canismarko/pulsemixer/pulsemixer_pcb/pulsemixer_pcb.png

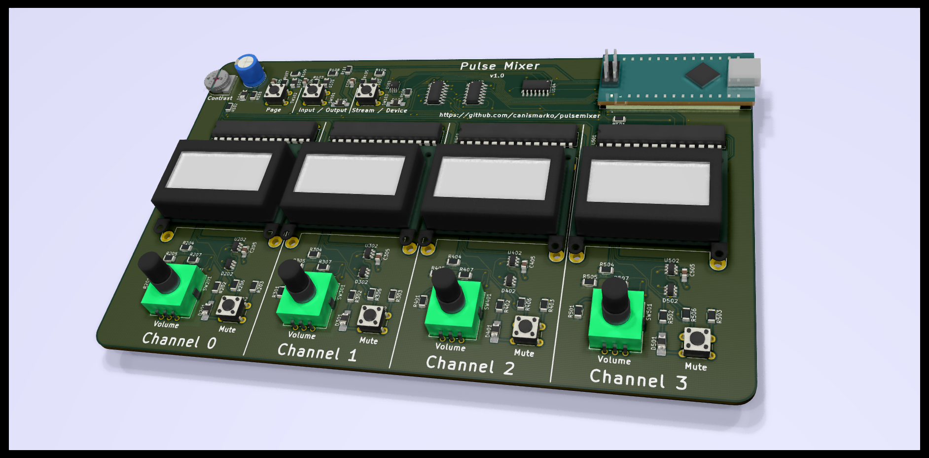
pulsemixer_pcb/pulsemixer_pcb.png
