canismarko/pulsemixer/serial_instructions.txt

* Host-To-Client
* Client-To-Host
** ``REFRESH CHANNELS``
   Ask the host to send an updated list of channel names.
