canismarko/pulsemixer/pulsemixer_pcb/NHD-0208AZ-FL-GBW.stp

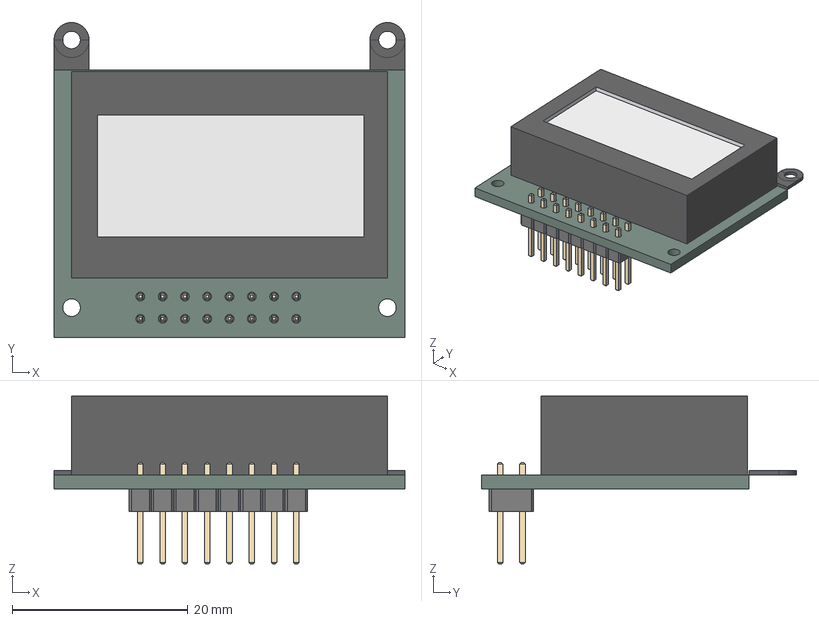
[picture p2: CAD file, 2020-07-25]
pulsemixer_pcb/NHD-0208AZ-FL-GBW.stp
40.0 x 35.9 x 19.1 mm
PinHeader
PCB001
Display001
Tab001
Tab002
