canismarko/pulsemixer/pulsemixer_pcb/EN12-HS.step

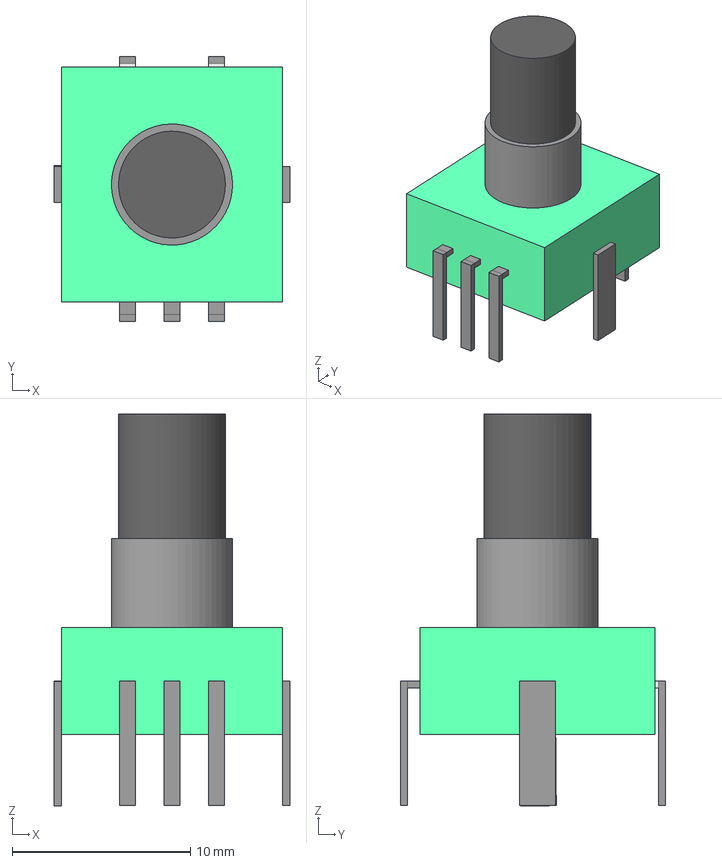
[picture p3: CAD file, 2020-07-25]
pulsemixer_pcb/EN12-HS.step
13.2 x 14.9 x 22.0 mm
BodyCube
Knob
Sheeth
BodyPins
RotaryPins
SwitchPins
