canismarko/pulsemixer/(list of files, cad)

Other CAD files:
pulsemixer_pcb/NHD-0208AZ-FL-BGW.FCStd
pulsemixer_pcb/EN12-HS.FCStd
