canismarko/pulsemixer/pulsemixer_pcb/pulsemixer_pcb.pdf

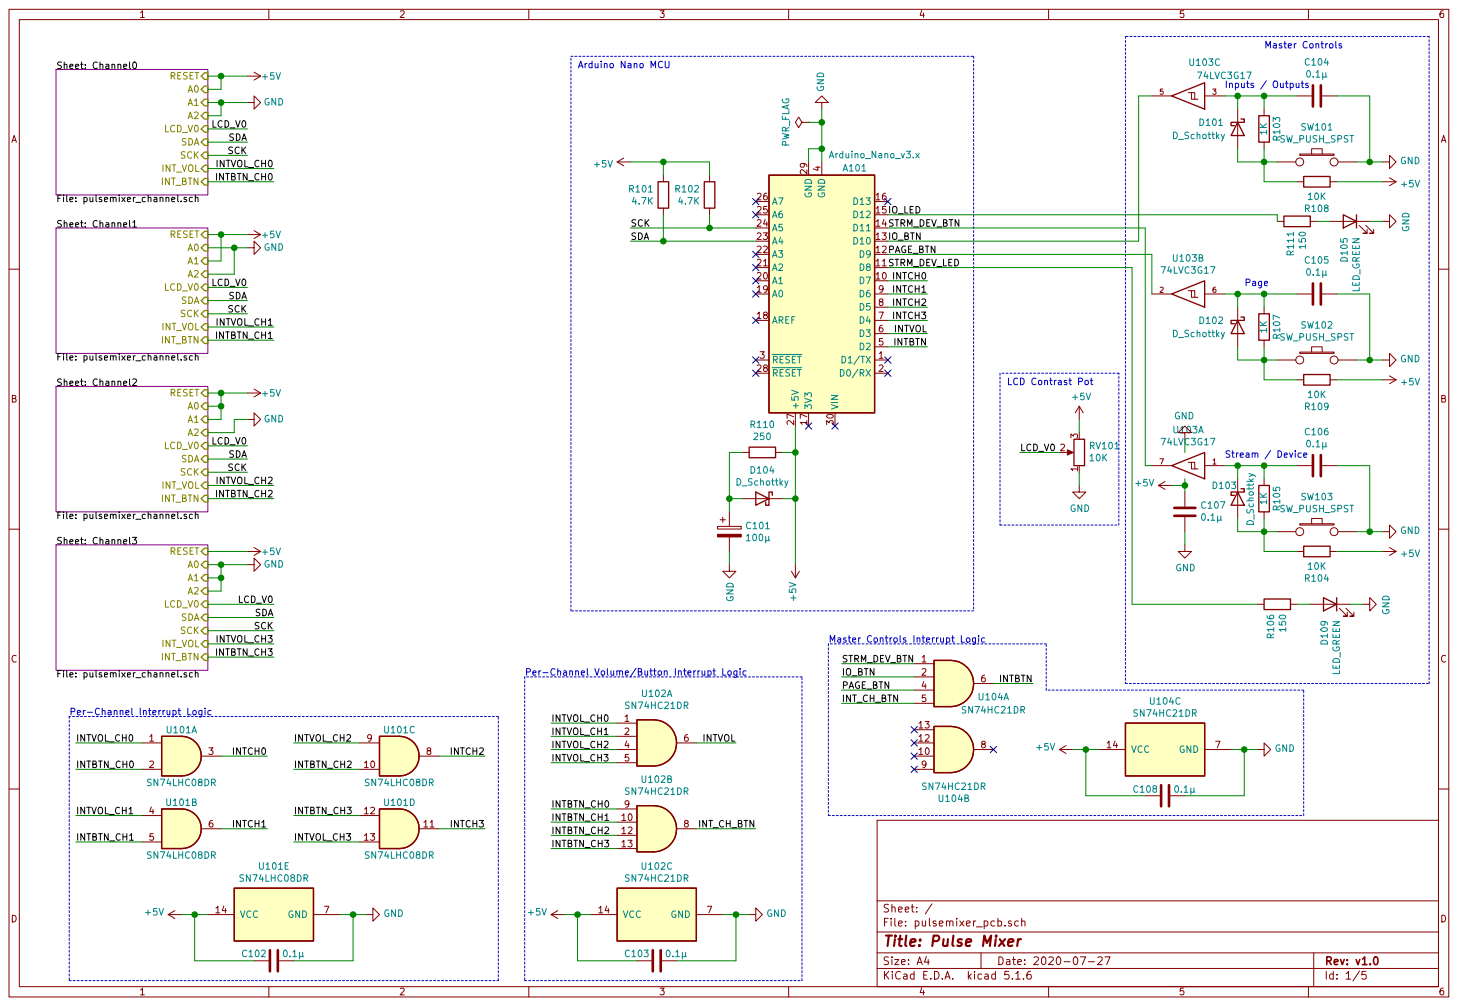
[picture p4: page 1]

LCD_V0 Sheet: Channel0 File: pulsemixer_channel.sch SCK

LCD Contrast Pot Arduino Nano MCU

LCD_V0 Sheet: Channel1 File: pulsemixer_channel.sch SCK

STRM_DEV_LED
INTCH0

LCD_V0 Sheet: Channel2 File: pulsemixer_channel.sch SCK

File: pulsemixer_pcb.sch Sheet: / Sheet: Channel3 File: pulsemixer_channel.sch SCK

Per-Channel Volume/Button Interrupt Logic

Per-Channel Interrupt Logic

Id: 1/5 Title: Pulse Mixer

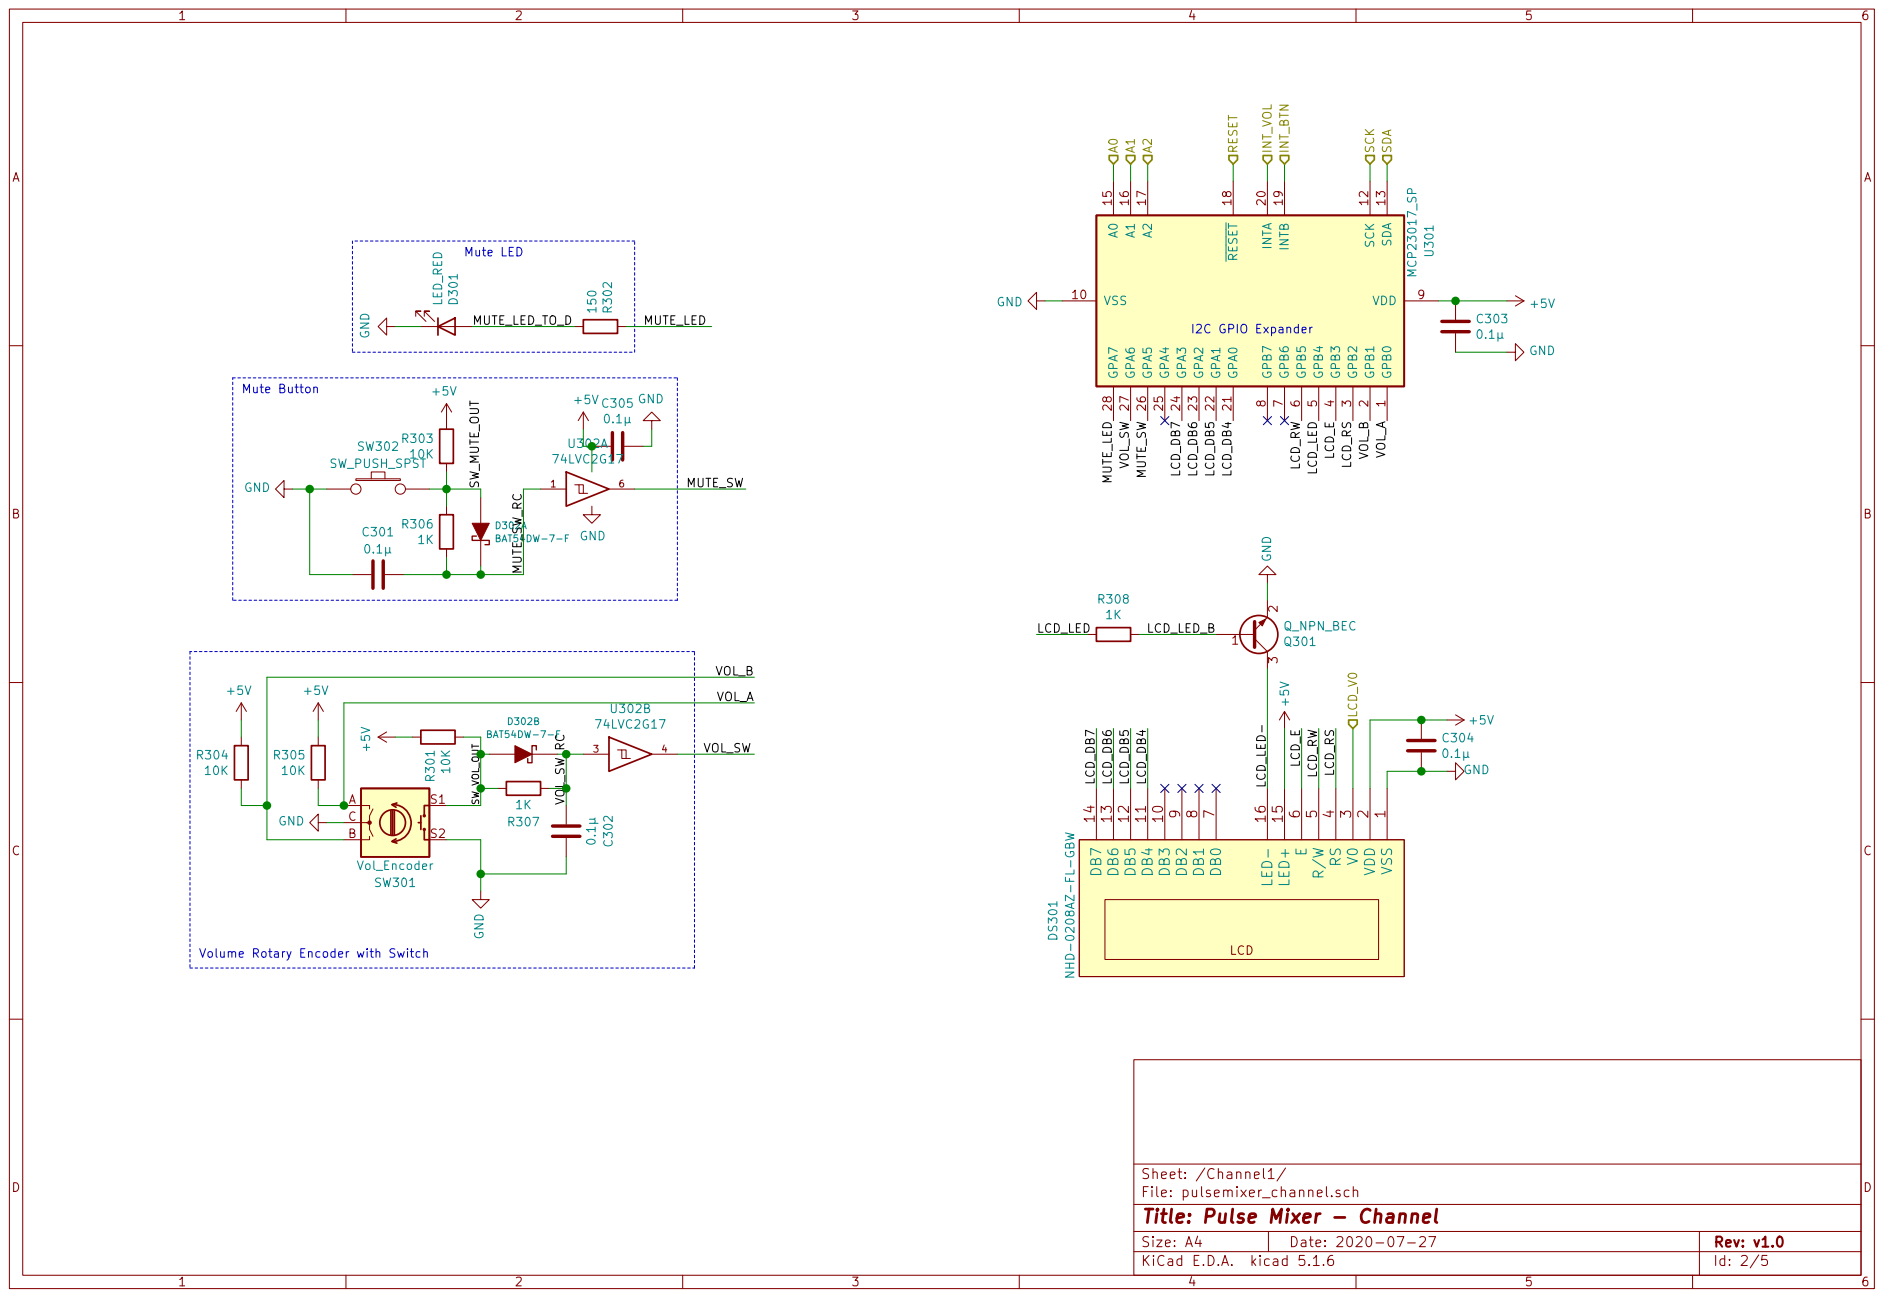
[picture p5: page 2]

I2C GPIO Expander Mute LED Mute Button Volume Rotary Encoder with Switch

File: pulsemixer_channel.sch Sheet: /Channel1/
Id: 2/5 Title: Pulse Mixer - Channel

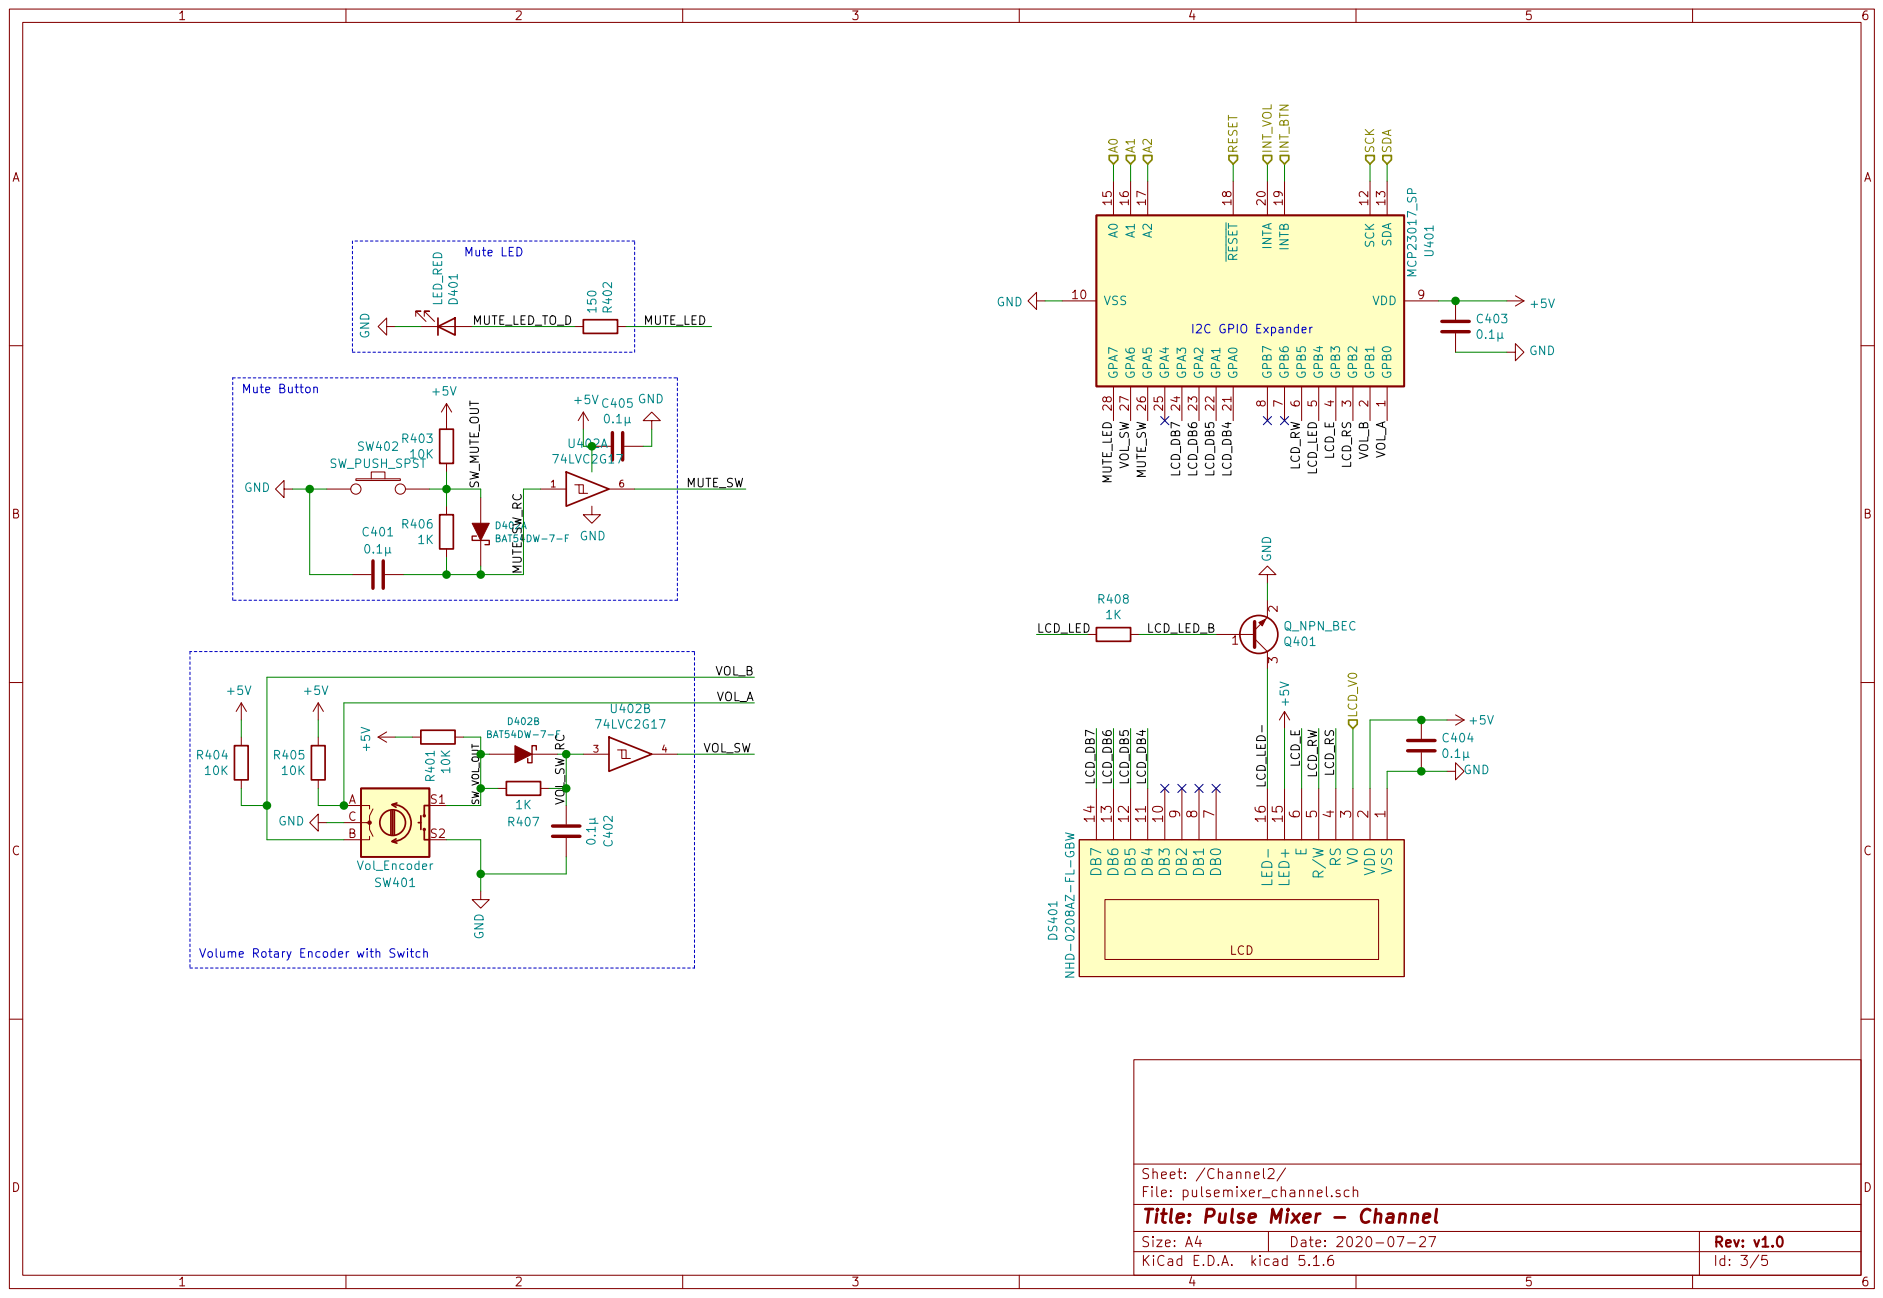
[picture p6: page 3]

I2C GPIO Expander Mute LED Mute Button Volume Rotary Encoder with Switch

File: pulsemixer_channel.sch Sheet: /Channel2/
Id: 3/5 Title: Pulse Mixer - Channel

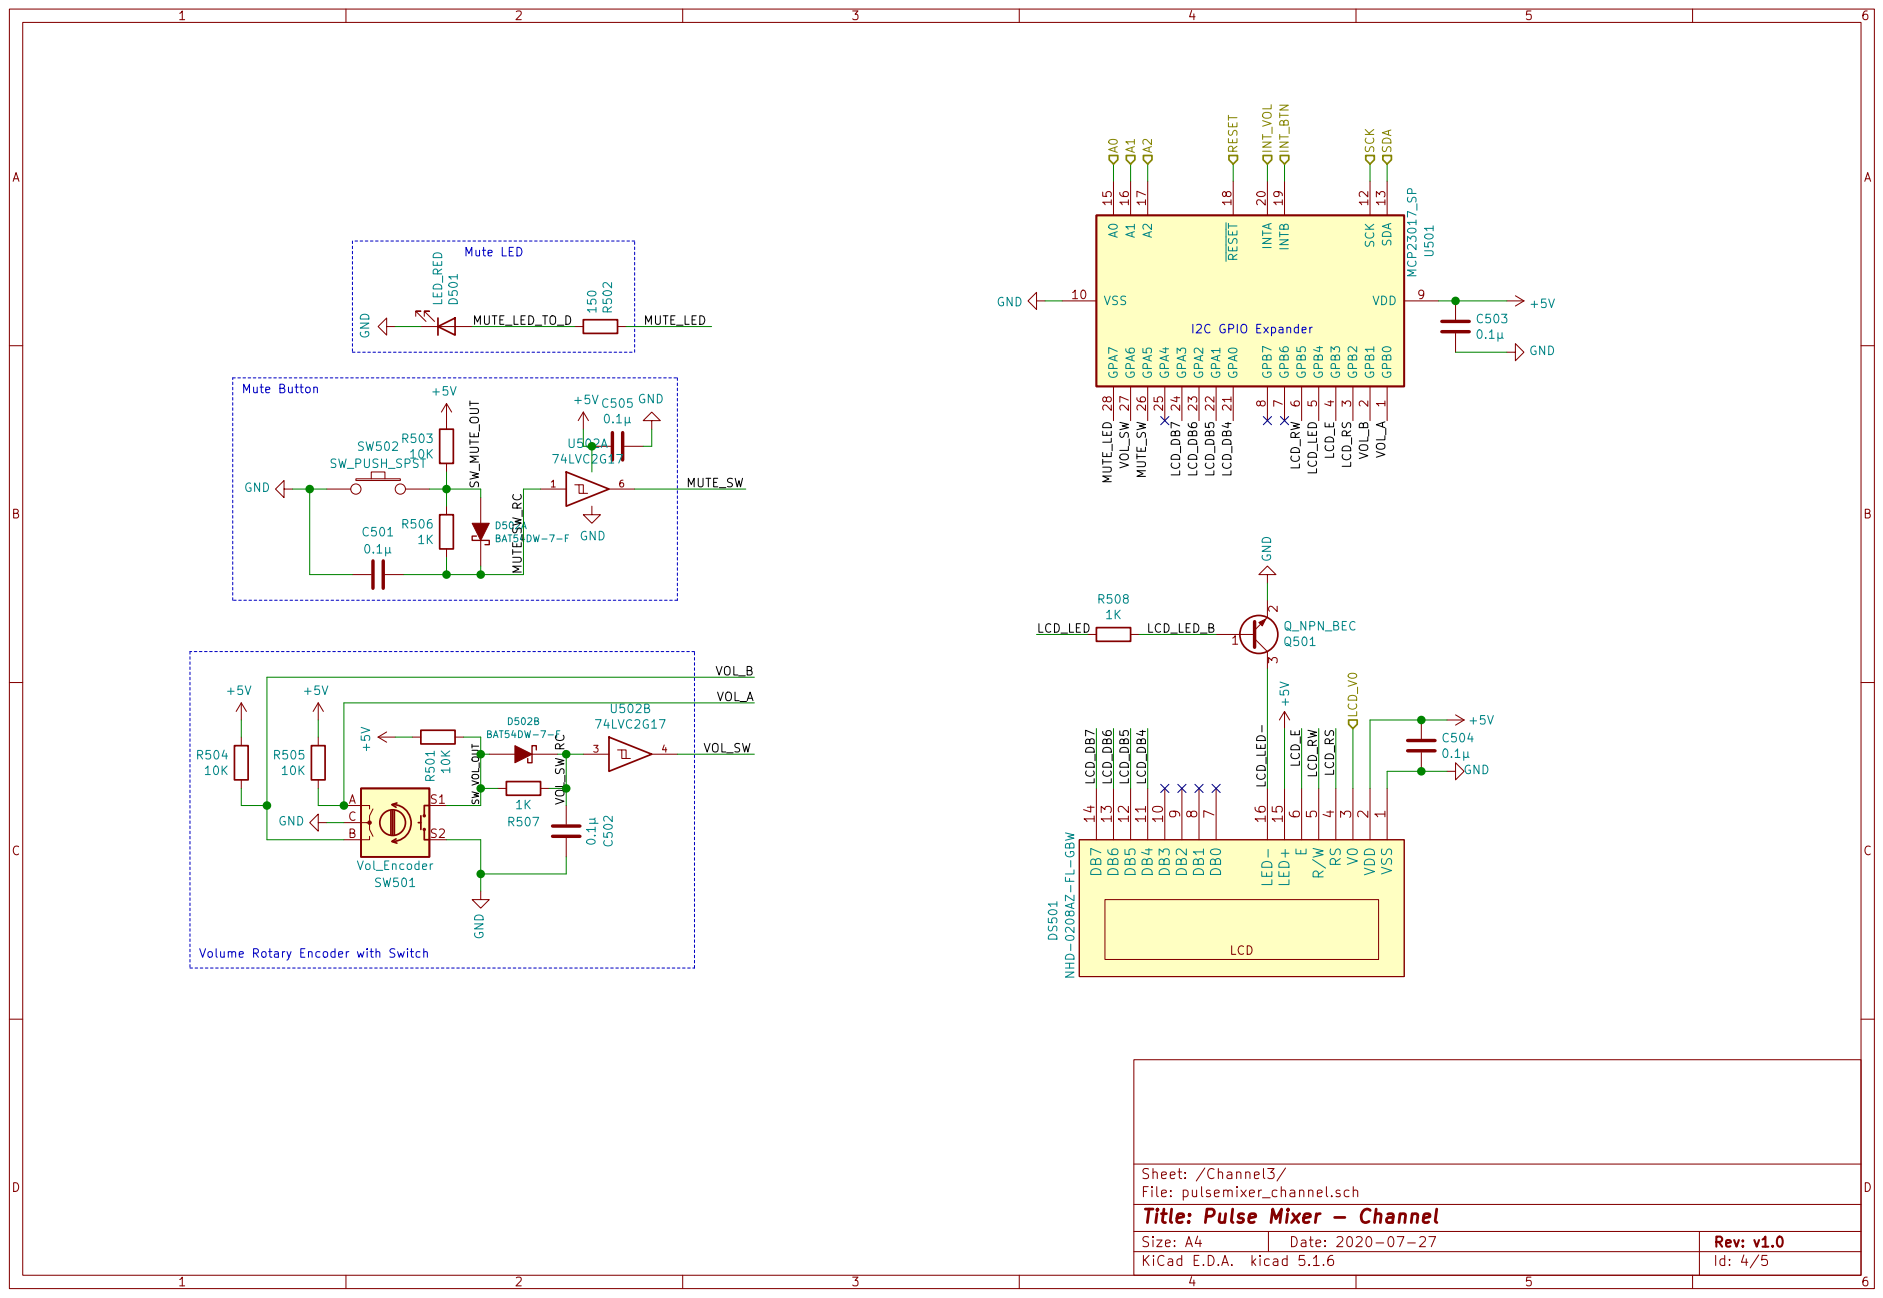
[picture p7: page 4]

I2C GPIO Expander Mute LED Mute Button Volume Rotary Encoder with Switch

File: pulsemixer_channel.sch Sheet: /Channel3/
Id: 4/5 Title: Pulse Mixer - Channel

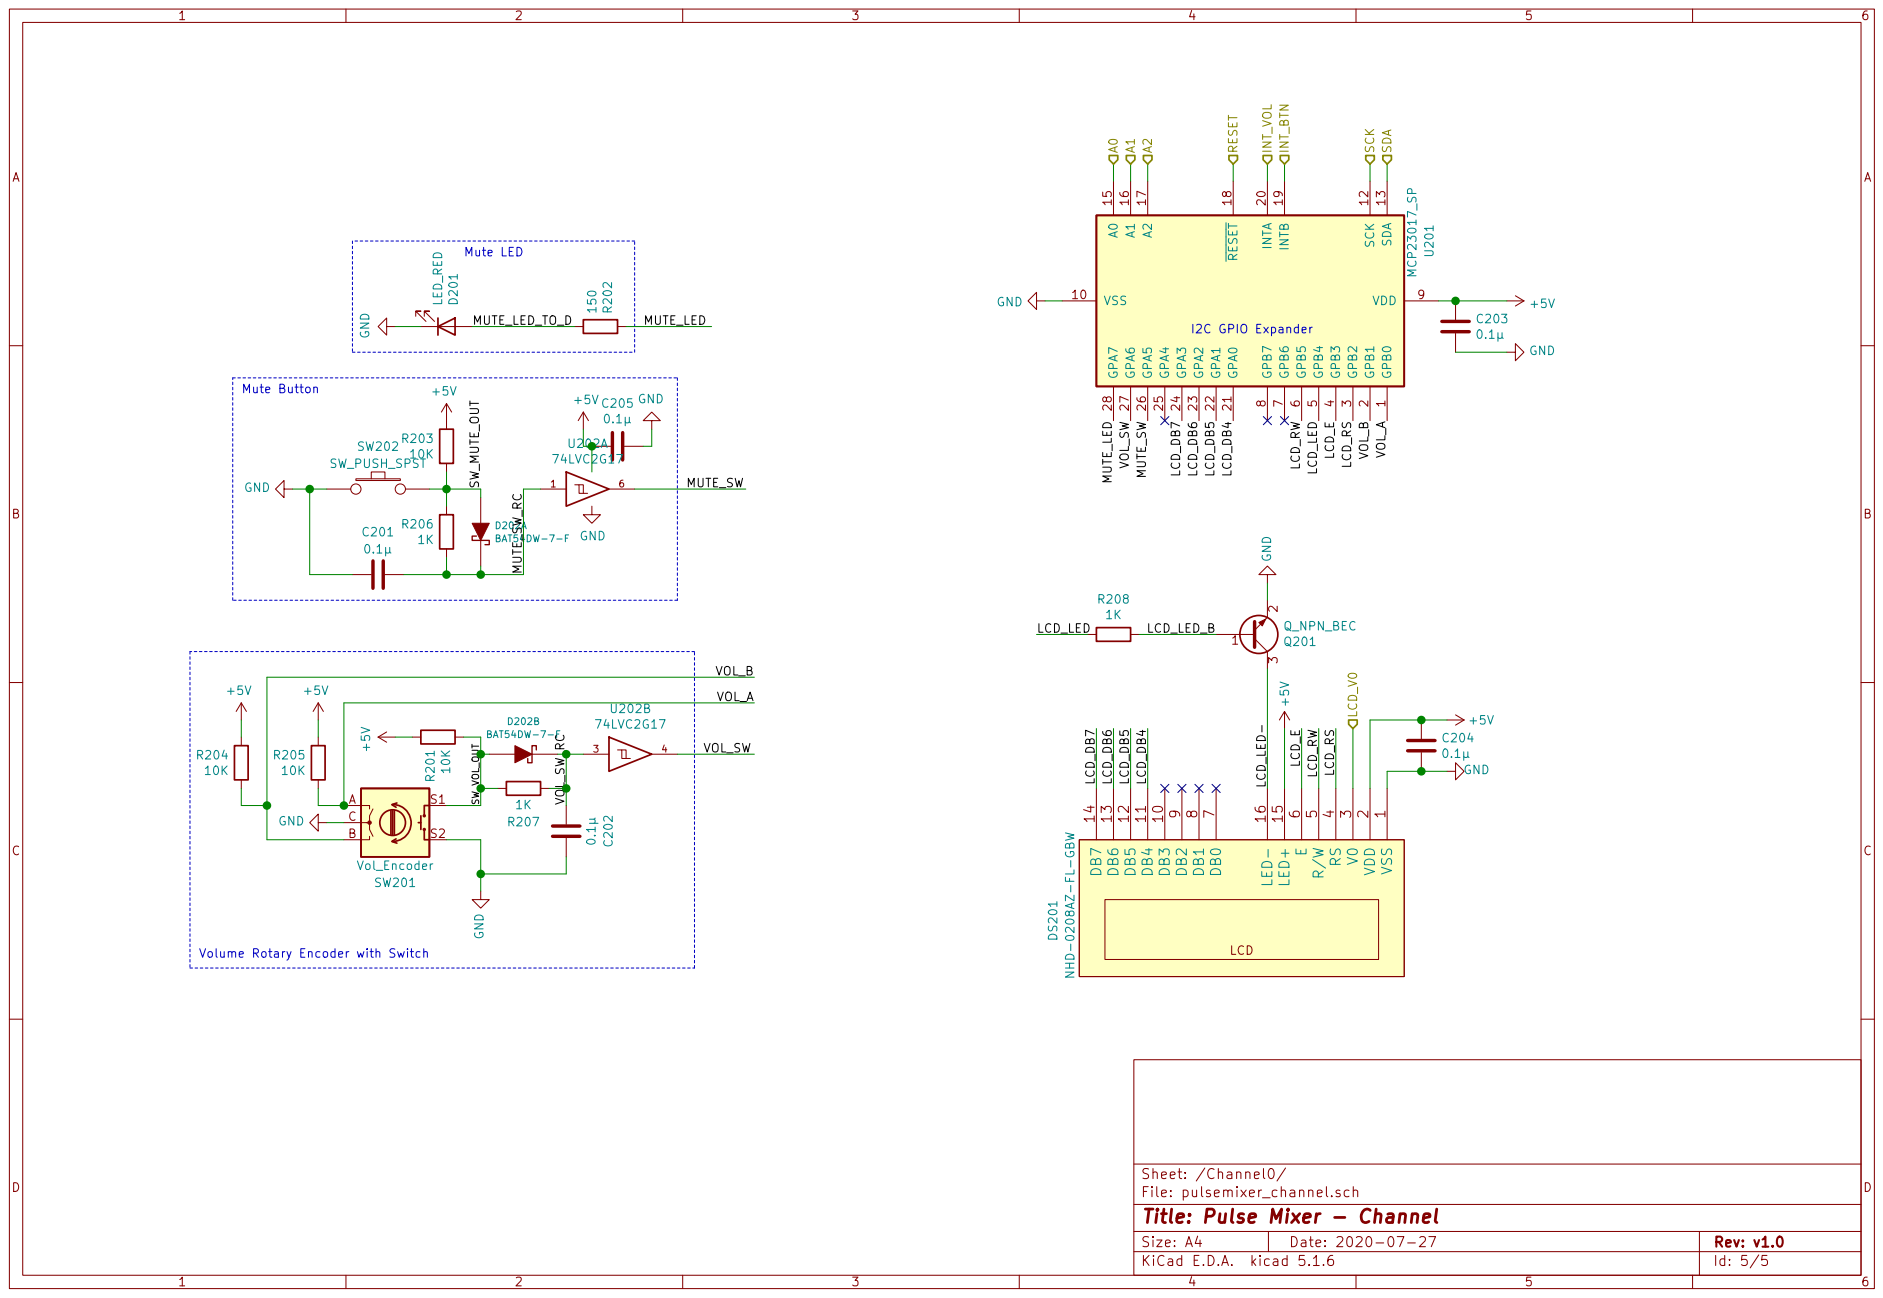
[picture p8: page 5]

I2C GPIO Expander Mute LED Mute Button Volume Rotary Encoder with Switch

File: pulsemixer_channel.sch Sheet: /Channel0/
Id: 5/5 Title: Pulse Mixer - Channel
