canismarko/pulsemixer/pulsemixer_pcb/pulsemixer_pcb.kicad_pcb

## KiCad design pulsemixer_pcb/pulsemixer_pcb.kicad_pcb (2020-08-07)

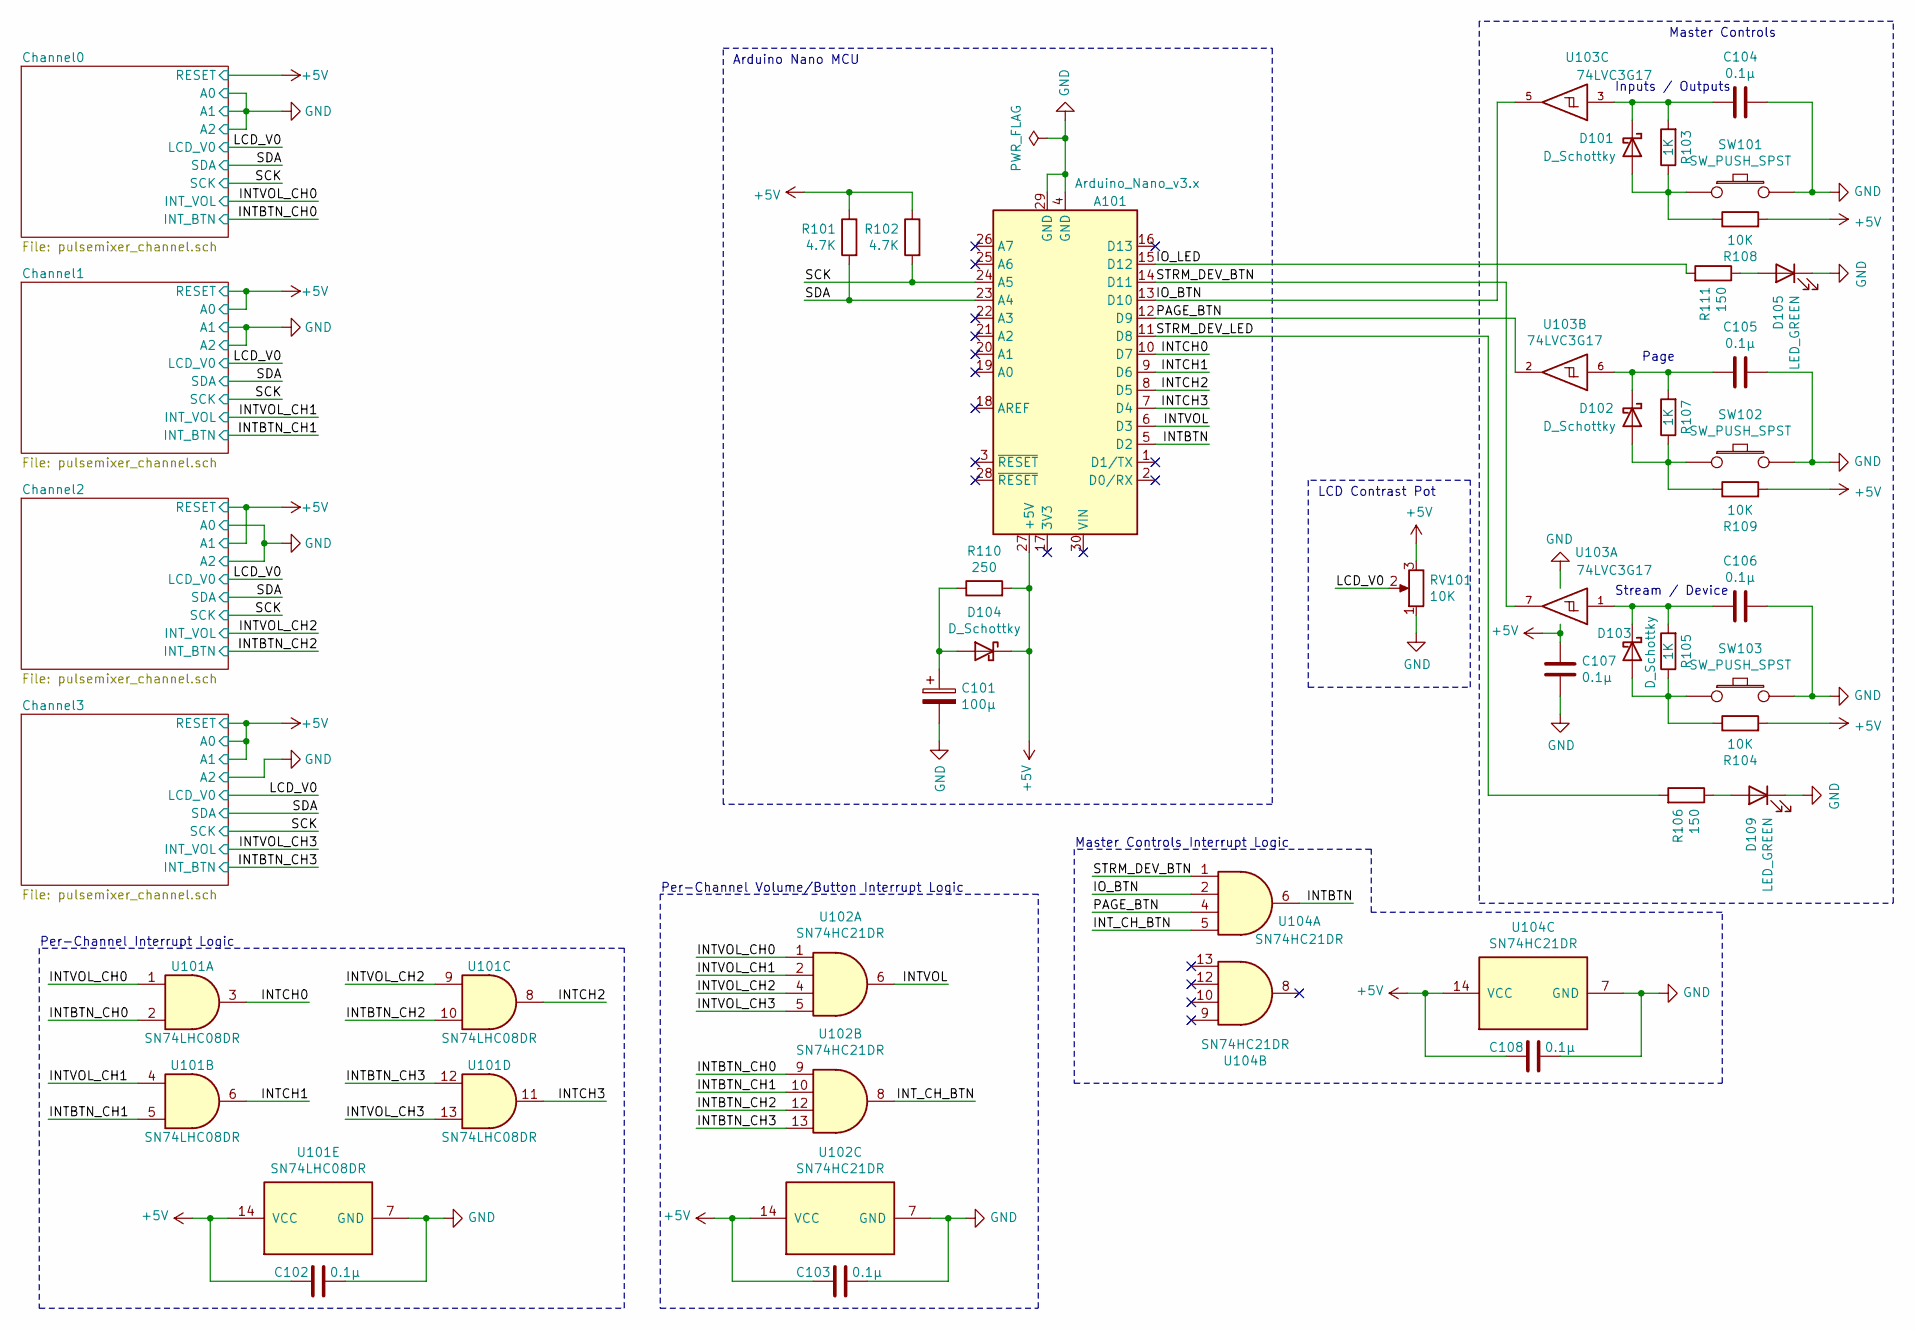
[picture p9: schematic pulsemixer_pcb.sch, Pulse Mixer]

Parts:
A101: Arduino_Nano_v3.x; SHIELD_ARDUINO_NANO
C101: 100µ; CP_Radial_D8.0mm_P3.50mm
C102, C103, C104, C105, C106, C107, C108: 0.1µ; C_0805_HandSoldering
D101, D102, D103, D104: D_Schottky; D_1206
D105, D109: LED_GREEN; LED_1206_HandSoldering
R101, R102: 4.7K; R_1206
R103, R105, R107: 1K; R_1206
R104, R108, R109: 10K; R_1206
R106, R111: 150; R_1206
R110: 250; R_1206
RV101: 10K; TRIM_3352T-1-103LF
SW101, SW102, SW103: SW_PUSH_SPST; SW_PUSH_6mm
U101: SN74LHC08DR; SOIC-14_3.9x8.7mm_Pitch1.27mm
U102, U104: SN74HC21DR; SOIC-14_3.9x8.7mm_Pitch1.27mm
U103: 74LVC3G17; SSOP-8_2.95x2.8mm_Pitch0.65mm

Connections:
+5V: A101.27 (+5V), C102.1, C103.1, C107.2, C108.2, D104.1 (K), R101.1, R102.1, R104.2, R108.2, R109.2, R110.2, RV101.3, U101.14 (VCC), U102.14 (VCC), U103.8 (VCC), U104.14 (VCC); also elsewhere on the board
/INTBTN: A101.5 (D2), U104.6
/INTBTN_CH0: U101.2, U102.9; also elsewhere on the board
/INTBTN_CH1: U101.5, U102.10; also elsewhere on the board
/INTBTN_CH2: U101.10, U102.12; also elsewhere on the board
/INTBTN_CH3: U101.12, U102.13; also elsewhere on the board
/INTCH0: A101.10 (D7), U101.3
/INTCH1: A101.9 (D6), U101.6
/INTCH2: A101.8 (D5), U101.8
/INTCH3: A101.7 (D4), U101.11
/INTVOL: A101.6 (D3), U102.6
/INTVOL_CH0: U101.1, U102.1; also elsewhere on the board
/INTVOL_CH1: U101.4, U102.2; also elsewhere on the board
/INTVOL_CH2: U101.9, U102.4; also elsewhere on the board
/INTVOL_CH3: U101.13, U102.5; also elsewhere on the board
/INT_CH_BTN: U102.8, U104.5
/IO_BTN: A101.13 (D10), U103.5, U104.2
/IO_LED: A101.15 (D12), R111.2
/LCD_V0: RV101.2; also elsewhere on the board
/PAGE_BTN: A101.12 (D9), U103.2, U104.4
/SCK: A101.24 (A5), R102.2; also elsewhere on the board
/SDA: A101.23 (A4), R101.2; also elsewhere on the board
/STRM_DEV_BTN: A101.14 (D11), U103.7, U104.1
/STRM_DEV_LED: A101.11 (D8), R106.2
GND: A101.4 (GND), A101.29 (GND), C101.2, C102.2, C103.2, C104.2, C105.2, C106.2, C107.1, C108.1, D105.1 (K), D109.1 (K), RV101.1, SW101.2, SW102.2, SW103.2, U101.7 (GND), U102.7 (GND), U103.4 (GND), U104.7 (GND); also elsewhere on the board
unnamed: C101.1, D104.2 (A), R110.1
unnamed: C104.1, D101.1 (K), R103.2, U103.3
unnamed: C105.1, D102.1 (K), R107.2, U103.6
unnamed: C106.1, D103.1 (K), R105.2, U103.1
unnamed: D101.2 (A), R103.1, R108.1, SW101.1
unnamed: D102.2 (A), R107.1, R109.1, SW102.1
unnamed: D103.2 (A), R104.1, R105.1, SW103.1
unnamed: D105.2 (A), R111.1
unnamed: D109.2 (A), R106.1

Notes on the sheet:
LCD Contrast Pot
Arduino Nano MCU
Per-Channel Interrupt Logic
Per-Channel Volume/Button Interrupt Logic
Master Controls
Stream / Device
Page
Inputs / Outputs
Master Controls Interrupt Logic

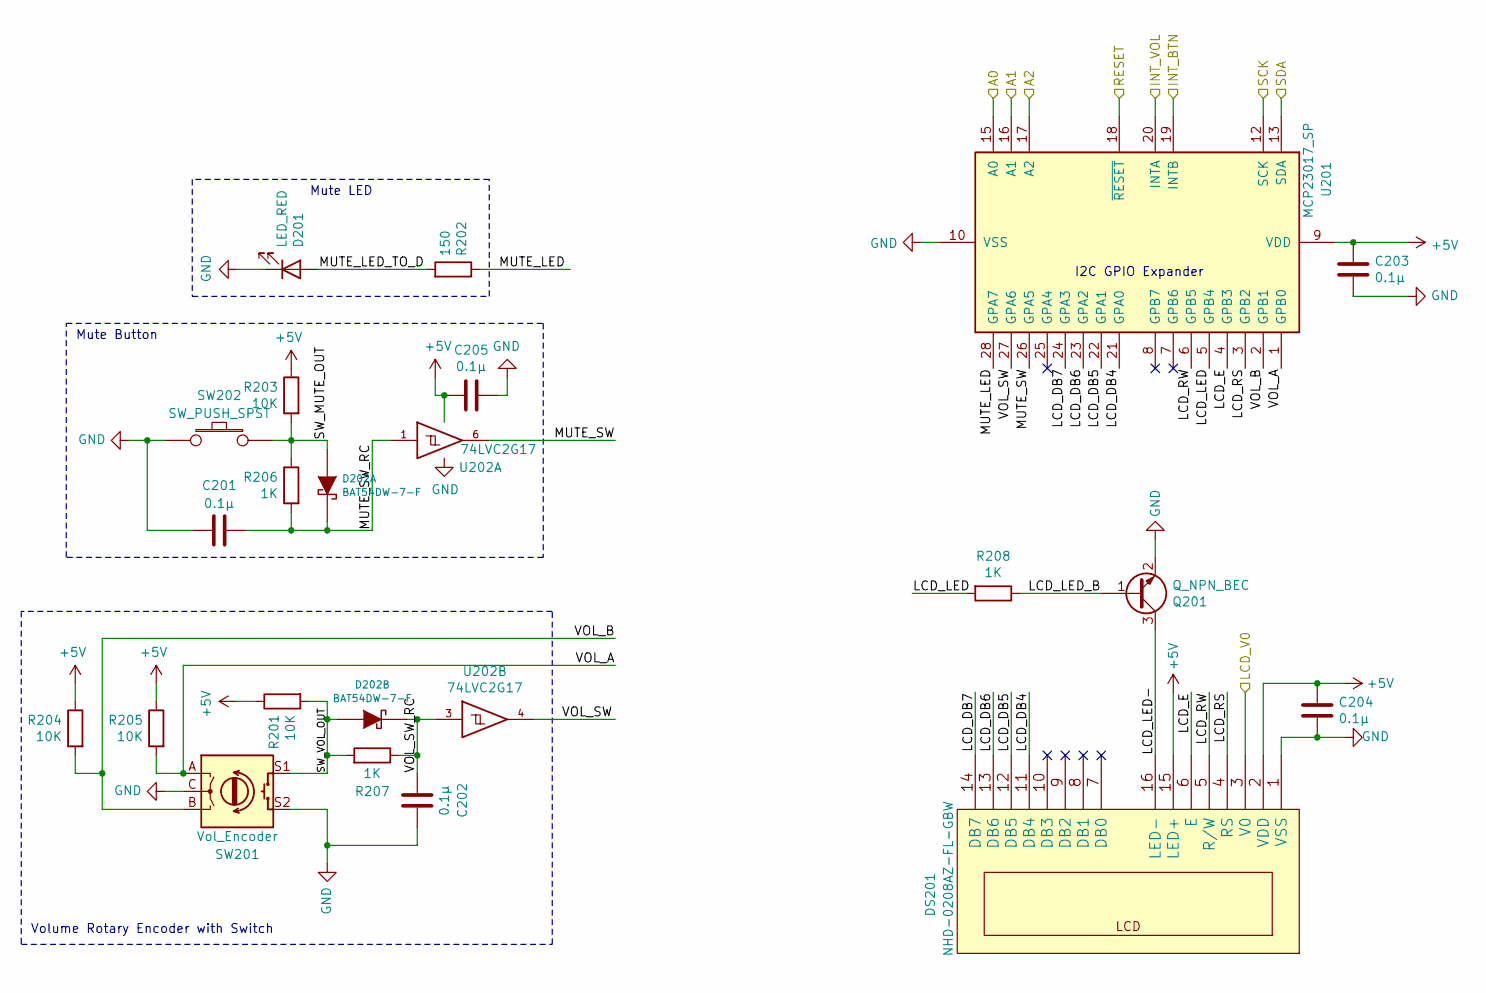
[picture p10: schematic pulsemixer_channel.sch, Pulse Mixer - Channel]

Parts:
C501, C502, C503, C504, C505: 0.1µ; C_0805_HandSoldering
D501: LED_RED; LED_1206_HandSoldering
D502: BAT54DW-7-F; Diode_Dual_SOT-23-6
DS501: NHD-0208AZ-FL-GBW
Q201: Q_NPN_BEC; SOT-23
R501, R503, R504, R505: 10K; R_1206
R502: 150; R_1206
R506, R507, R508: 1K; R_1206
SW501: Vol_Encoder; EN12-HS22AF18
SW502: SW_PUSH_SPST; SW_PUSH_6mm
U501: MCP23017_SP; DIP-28_W7.62mm
U502: 74LVC2G17; SOT-23-6

Connections:
+5V: C503.1, C504.1, C505.2, DS501.2 (VDD), DS501.15 (LED+), R501.1, R503.1, R504.1, R505.1, U501.9 (VDD), U501.15 (A0), U501.16 (A1), U501.18 (~RESET~), U502.5 (VCC); also elsewhere on the board
/Channel3/LCD_DB4: DS501.11 (DB4), U501.21 (GPA0)
/Channel3/LCD_DB5: DS501.12 (DB5), U501.22 (GPA1)
/Channel3/LCD_DB6: DS501.13 (DB6), U501.23 (GPA2)
/Channel3/LCD_DB7: DS501.14 (DB7), U501.24 (GPA3)
/Channel3/LCD_E: DS501.6 (E), U501.4 (GPB3)
/Channel3/LCD_LED: R508.2, U501.5 (GPB4)
/Channel3/LCD_RS: DS501.4 (RS), U501.3 (GPB2)
/Channel3/LCD_RW: DS501.5 (R/W), U501.6 (GPB5)
/Channel3/MUTE_LED: R502.1, U501.28 (GPA7)
/Channel3/MUTE_LED_TO_D: D501.2 (A), R502.2
/Channel3/MUTE_SW: U501.26 (GPA5), U502.6
/Channel3/MUTE_SW_RC: C501.2, D502.6 (C1), R506.2, U502.1
/Channel3/SW_MUTE_OUT: D502.1 (A1), R503.2, R506.1, SW502.1
/Channel3/SW_VOL_OUT: D502.4 (A2), R501.2, R507.2, SW501.S1
/Channel3/VOL_A: R505.2, SW501.A, U501.1 (GPB0)
/Channel3/VOL_B: R504.2, SW501.B, U501.2 (GPB1)
/Channel3/VOL_SW: U501.27 (GPA6), U502.4
/Channel3/VOL_SW_RC: C502.2, D502.3 (C2), R507.1, U502.3
/INTBTN_CH3: U501.19 (INTB); also elsewhere on the board
/INTVOL_CH3: U501.20 (INTA); also elsewhere on the board
/LCD_V0: DS501.3 (V0); also elsewhere on the board
/SCK: U501.12 (SCK); also elsewhere on the board
/SDA: U501.13 (SDA); also elsewhere on the board
GND: C501.1, C502.1, C503.2, C504.2, C505.1, D501.1 (K), DS501.1 (VSS), Q201.2 (E), SW501.C, SW501.S2, SW502.2, U501.10 (VSS), U501.17 (A2), U502.2 (GND); also elsewhere on the board

Parts of its further copies:
C201, C202, C203, C204, C205, C301, C302, C303, C304, C305, C401, C402, C403, C404, C405: 0.1µ; C_0805_HandSoldering
D201, D301, D401: LED_RED; LED_1206_HandSoldering
D202, D302, D402: BAT54DW-7-F; Diode_Dual_SOT-23-6
DS201, DS301, DS401: NHD-0208AZ-FL-GBW
Q301, Q401, Q501: Q_NPN_BEC; SOT-23
R201, R203, R204, R205, R301, R303, R304, R305, R401, R403, R404, R405: 10K; R_1206
R202, R302, R402: 150; R_1206
R206, R207, R208, R306, R307, R308, R406, R407, R408: 1K; R_1206
SW201, SW301, SW401: Vol_Encoder; EN12-HS22AF18
SW202, SW302, SW402: SW_PUSH_SPST; SW_PUSH_6mm
U201, U301, U401: MCP23017_SP; DIP-28_W7.62mm
U202, U302, U402: 74LVC2G17; SOT-23-6

Connections of its further copies:
+5V: C203.1, C204.1, C205.2, C303.1, C304.1, C305.2, C403.1, C404.1, C405.2, DS201.2 (VDD), DS201.15 (LED+), DS301.2 (VDD), DS301.15 (LED+), DS401.2 (VDD), DS401.15 (LED+), R201.1, R203.1, R204.1, R205.1, R301.1, R303.1, R304.1, R305.1, R401.1, R403.1, R404.1, R405.1, U201.9 (VDD), U201.18 (~RESET~), U202.5 (VCC), U301.9 (VDD), U301.15 (A0), U301.18 (~RESET~), U302.5 (VCC), U401.9 (VDD), U401.16 (A1), U401.18 (~RESET~), U402.5 (VCC); also elsewhere on the board
/Channel0/LCD_DB4: DS201.11 (DB4), U201.21 (GPA0)
/Channel0/LCD_DB5: DS201.12 (DB5), U201.22 (GPA1)
/Channel0/LCD_DB6: DS201.13 (DB6), U201.23 (GPA2)
/Channel0/LCD_DB7: DS201.14 (DB7), U201.24 (GPA3)
/Channel0/LCD_E: DS201.6 (E), U201.4 (GPB3)
/Channel0/LCD_LED: R208.2, U201.5 (GPB4)
/Channel0/LCD_RS: DS201.4 (RS), U201.3 (GPB2)
/Channel0/LCD_RW: DS201.5 (R/W), U201.6 (GPB5)
/Channel0/MUTE_LED: R202.1, U201.28 (GPA7)
/Channel0/MUTE_LED_TO_D: D201.2 (A), R202.2
/Channel0/MUTE_SW: U201.26 (GPA5), U202.6
/Channel0/MUTE_SW_RC: C201.2, D202.6 (C1), R206.2, U202.1
/Channel0/SW_MUTE_OUT: D202.1 (A1), R203.2, R206.1, SW202.1
/Channel0/SW_VOL_OUT: D202.4 (A2), R201.2, R207.2, SW201.S1
/Channel0/VOL_A: R205.2, SW201.A, U201.1 (GPB0)
/Channel0/VOL_B: R204.2, SW201.B, U201.2 (GPB1)
/Channel0/VOL_SW: U201.27 (GPA6), U202.4
/Channel0/VOL_SW_RC: C202.2, D202.3 (C2), R207.1, U202.3
/Channel1/LCD_DB4: DS301.11 (DB4), U301.21 (GPA0)
/Channel1/LCD_DB5: DS301.12 (DB5), U301.22 (GPA1)
/Channel1/LCD_DB6: DS301.13 (DB6), U301.23 (GPA2)
/Channel1/LCD_DB7: DS301.14 (DB7), U301.24 (GPA3)
/Channel1/LCD_E: DS301.6 (E), U301.4 (GPB3)
/Channel1/LCD_LED: R308.2, U301.5 (GPB4)
/Channel1/LCD_LED-: DS301.16 (LED-), Q301.3 (C)
/Channel1/LCD_LED_B: Q301.1 (B), R308.1
/Channel1/LCD_RS: DS301.4 (RS), U301.3 (GPB2)
/Channel1/LCD_RW: DS301.5 (R/W), U301.6 (GPB5)
/Channel1/MUTE_LED: R302.1, U301.28 (GPA7)
/Channel1/MUTE_LED_TO_D: D301.2 (A), R302.2
/Channel1/MUTE_SW: U301.26 (GPA5), U302.6
/Channel1/MUTE_SW_RC: C301.2, D302.6 (C1), R306.2, U302.1
/Channel1/SW_MUTE_OUT: D302.1 (A1), R303.2, R306.1, SW302.1
/Channel1/SW_VOL_OUT: D302.4 (A2), R301.2, R307.2, SW301.S1
/Channel1/VOL_A: R305.2, SW301.A, U301.1 (GPB0)
/Channel1/VOL_B: R304.2, SW301.B, U301.2 (GPB1)
/Channel1/VOL_SW: U301.27 (GPA6), U302.4
/Channel1/VOL_SW_RC: C302.2, D302.3 (C2), R307.1, U302.3
/Channel2/LCD_DB4: DS401.11 (DB4), U401.21 (GPA0)
/Channel2/LCD_DB5: DS401.12 (DB5), U401.22 (GPA1)
/Channel2/LCD_DB6: DS401.13 (DB6), U401.23 (GPA2)
/Channel2/LCD_DB7: DS401.14 (DB7), U401.24 (GPA3)
/Channel2/LCD_E: DS401.6 (E), U401.4 (GPB3)
/Channel2/LCD_LED: R408.2, U401.5 (GPB4)
/Channel2/LCD_LED-: DS401.16 (LED-), Q401.3 (C)
/Channel2/LCD_LED_B: Q401.1 (B), R408.1
/Channel2/LCD_RS: DS401.4 (RS), U401.3 (GPB2)
/Channel2/LCD_RW: DS401.5 (R/W), U401.6 (GPB5)
/Channel2/MUTE_LED: R402.1, U401.28 (GPA7)
/Channel2/MUTE_LED_TO_D: D401.2 (A), R402.2
/Channel2/MUTE_SW: U401.26 (GPA5), U402.6
/Channel2/MUTE_SW_RC: C401.2, D402.6 (C1), R406.2, U402.1
/Channel2/SW_MUTE_OUT: D402.1 (A1), R403.2, R406.1, SW402.1
/Channel2/SW_VOL_OUT: D402.4 (A2), R401.2, R407.2, SW401.S1
/Channel2/VOL_A: R405.2, SW401.A, U401.1 (GPB0)
/Channel2/VOL_B: R404.2, SW401.B, U401.2 (GPB1)
/Channel2/VOL_SW: U401.27 (GPA6), U402.4
/Channel2/VOL_SW_RC: C402.2, D402.3 (C2), R407.1, U402.3
/INTBTN_CH0: U201.19 (INTB); also elsewhere on the board
/INTBTN_CH1: U301.19 (INTB); also elsewhere on the board
/INTBTN_CH2: U401.19 (INTB); also elsewhere on the board
/INTVOL_CH0: U201.20 (INTA); also elsewhere on the board
/INTVOL_CH1: U301.20 (INTA); also elsewhere on the board
/INTVOL_CH2: U401.20 (INTA); also elsewhere on the board
/LCD_V0: DS201.3 (V0), DS301.3 (V0), DS401.3 (V0); also elsewhere on the board
/SCK: U201.12 (SCK), U301.12 (SCK), U401.12 (SCK); also elsewhere on the board
/SDA: U201.13 (SDA), U301.13 (SDA), U401.13 (SDA); also elsewhere on the board
GND: C201.1, C202.1, C203.2, C204.2, C205.1, C301.1, C302.1, C303.2, C304.2, C305.1, C401.1, C402.1, C403.2, C404.2, C405.1, D201.1 (K), D301.1 (K), D401.1 (K), DS201.1 (VSS), DS301.1 (VSS), DS401.1 (VSS), Q301.2 (E), Q401.2 (E), Q501.2 (E), SW201.C, SW201.S2, SW202.2, SW301.C, SW301.S2, SW302.2, SW401.C, SW401.S2, SW402.2, U201.10 (VSS), U201.15 (A0), U201.16 (A1), U201.17 (A2), U202.2 (GND), U301.10 (VSS), U301.16 (A1), U301.17 (A2), U302.2 (GND), U401.10 (VSS), U401.15 (A0), U401.17 (A2), U402.2 (GND); also elsewhere on the board

Notes on the sheet:
Volume Rotary Encoder with Switch
Mute Button
Mute LED
I2C GPIO Expander

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
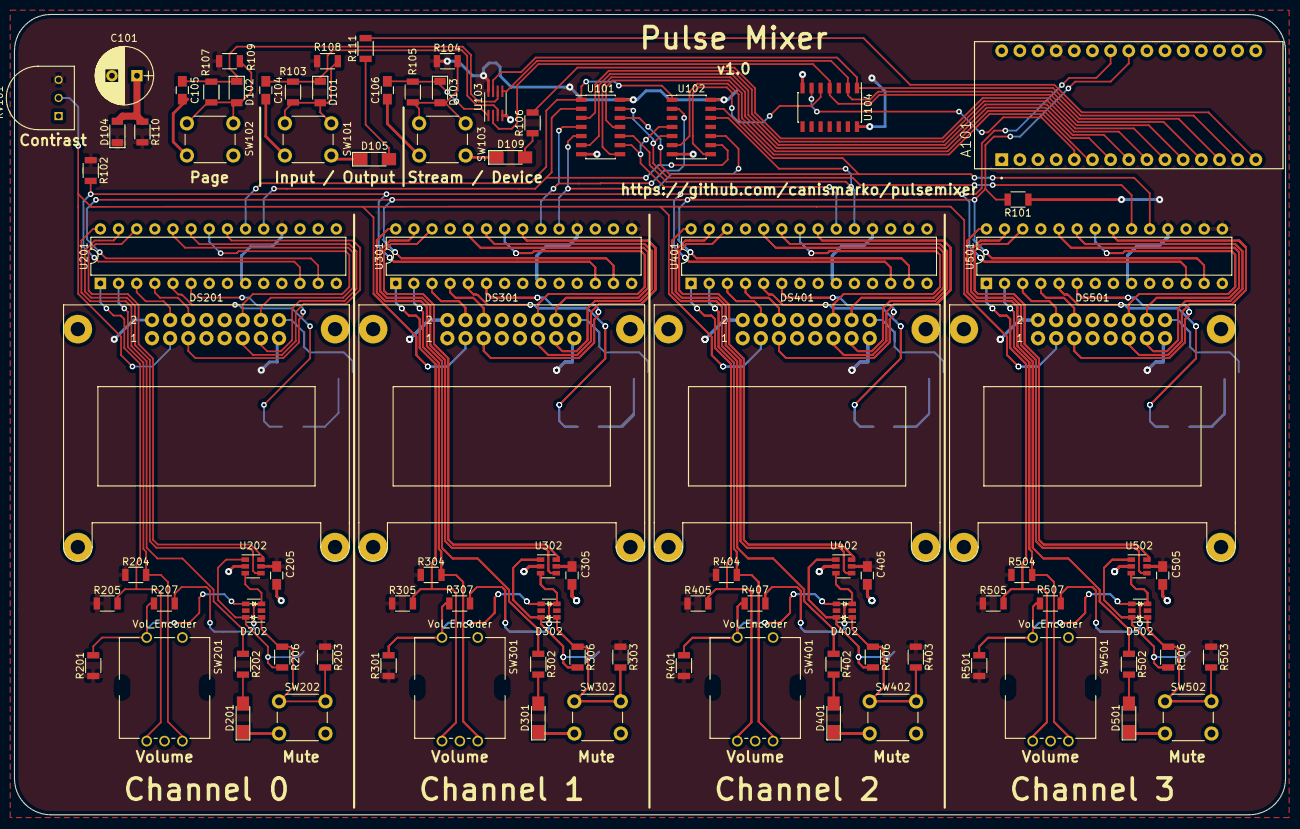
[picture p11: board pulsemixer_pcb.kicad_pcb from above]

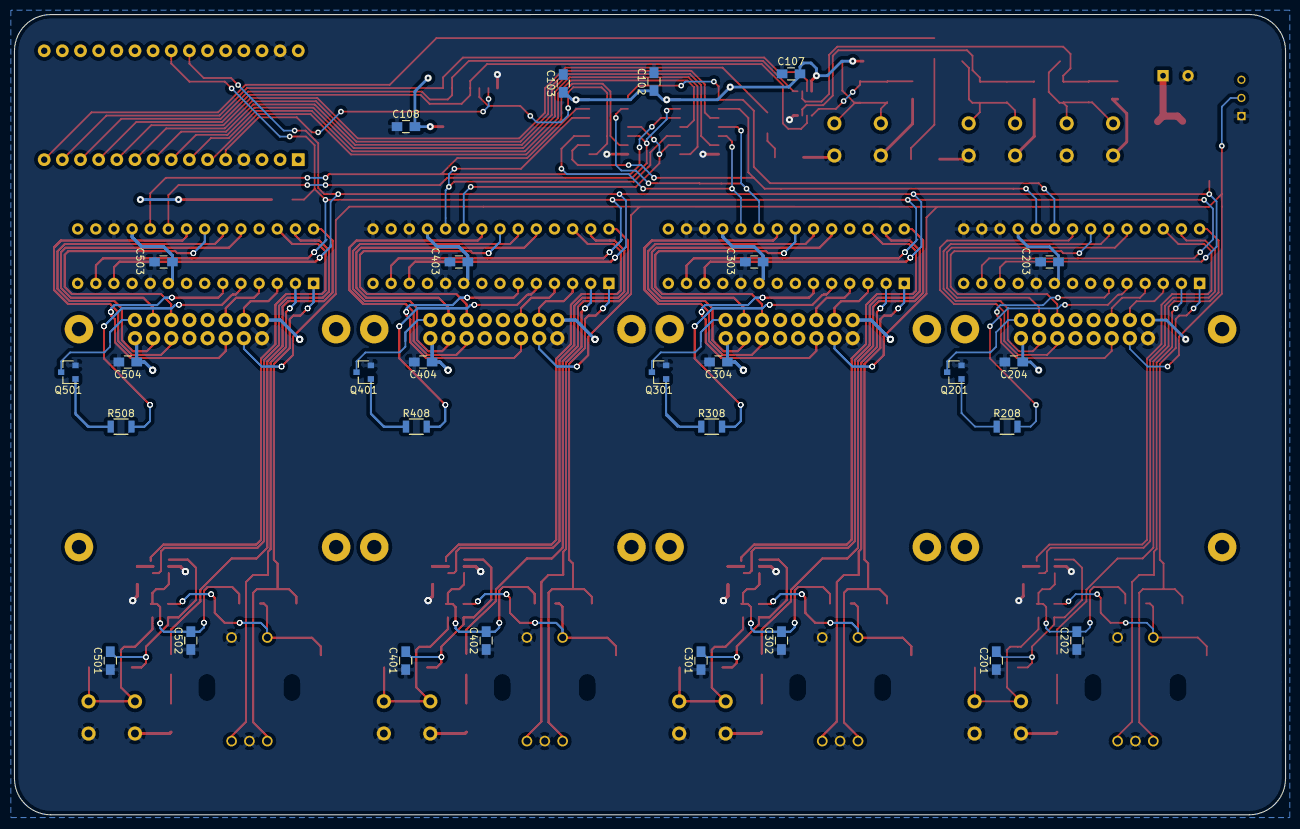
[picture p12: board pulsemixer_pcb.kicad_pcb from below]

Board: 2 copper layers, 177.9 x 112.0 mm, 118 parts (28 on the bottom side), 114 nets.
