canismarko/pulsemixer/(commit log)

2020-06-21 Initial basic design, firmware and software for breadboard mixer.
    [pulsemixer_pcb.kicad_pcb, pulsemixer_pcb.sch]
2020-06-29 Finished inital schematic, and a little bit of PCB layout.
    [pulsemixer_channel.sch, pulsemixer_pcb.sch]
2020-07-03 Revised schematic after testing rotary encoder.
    [pulsemixer_channel.sch, pulsemixer_pcb.kicad_pcb, pulsemixer_pcb.sch]
2020-07-05 Simple reading of rotary encoder through the GPIO expander, with interrupts.
    [pulsemixer_channel.sch, pulsemixer_pcb.kicad_pcb, pulsemixer_pcb.sch]
2020-07-13 Rearranged LCD pins to allow for interrupts on both GPIO banks.
    [pulsemixer_channel.sch, pulsemixer_pcb.kicad_pcb]
2020-07-13 Firmware code to turn LCD backlight on and off.
    [pulsemixer_channel.sch]
2020-07-25 Finished full PCB layout.
    [EN12-HS.FCStd, EN12-HS.step, NHD-0208AZ-FL-BGW.FCStd, NHD-0208AZ-FL-GBW.stp, pulsemixer_channel.sch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]
2020-07-27 Added another AND gate to include master section buttons in the buttn interrupt logic.
    [pulsemixer_channel.sch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]
2020-08-07 Finalized changes to board and sent for fabrication.
    [pulsemixer_channel.sch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]
